minori24/VFDClock_LD8035/readme.md

# LD8035E VFD時計キット by Fablab Kannai

Fablab関内で開発した、VFD時計のキットです。Arduino Nanoをベースに、カシオミニで使われていたVFD管LD8035Eを6管点灯させるレトロな時計です。パーツ数を抑えたシンプルな構成ですが、ミニゲームやタイマーもついた高機能な時計です。

## 組み立て
[組み立てマニュアル](docs/assembly.md)
を参照して下さい。

## 設計情報
Cad: KiCad 5.0.2

プロジェクトデータはこのリポジトリにあります。

- [回路図 (PDF)](schematic/VFD_Clock_LD8035.pdf)

- [Arduino Code](Code)

## Contact

### 組み立てその他に関する問い合わせ

**Fablab Kannai**

http://fablab-kannai.org/

**Fablab Kannai @FB**

https://www.facebook.com/FabLabKannai/

### 設計情報について

@minori246

twitter.com/minori246
