minori24/VFDClock_LD8035/docs/kit.md

# Kit Preparation Checklist

## 部品(1台あたり)
- 基板 x1
- VFD(LD8035E) x6
- TBD62783APG x2
- Arduino Nano x1
- RTC Module (DS1307) x1
- ピンソケット(15ピン) x 2
- ピンソケット(5ピン) x 1
- ピンヘッダ(4ピン) x 2
- USB充電器 x 1
- USBケーブル x 1
- 抵抗(200Ω) x 6

## 下準備
### VFD
足カット

基板に差し込んで前後２箇所はんだ付け

### Arduino Nano
ピンヘッダはんだ付け

コード書き込み

### RTCモジュール
Diode外す

動作確認(動かなかったらR7に2012サイズ 680kOhmを実装してみる)
