minori24/VFDClock_LD8035/docs/images/50955239_2312329578779268_5980436892447932416_n.jpg

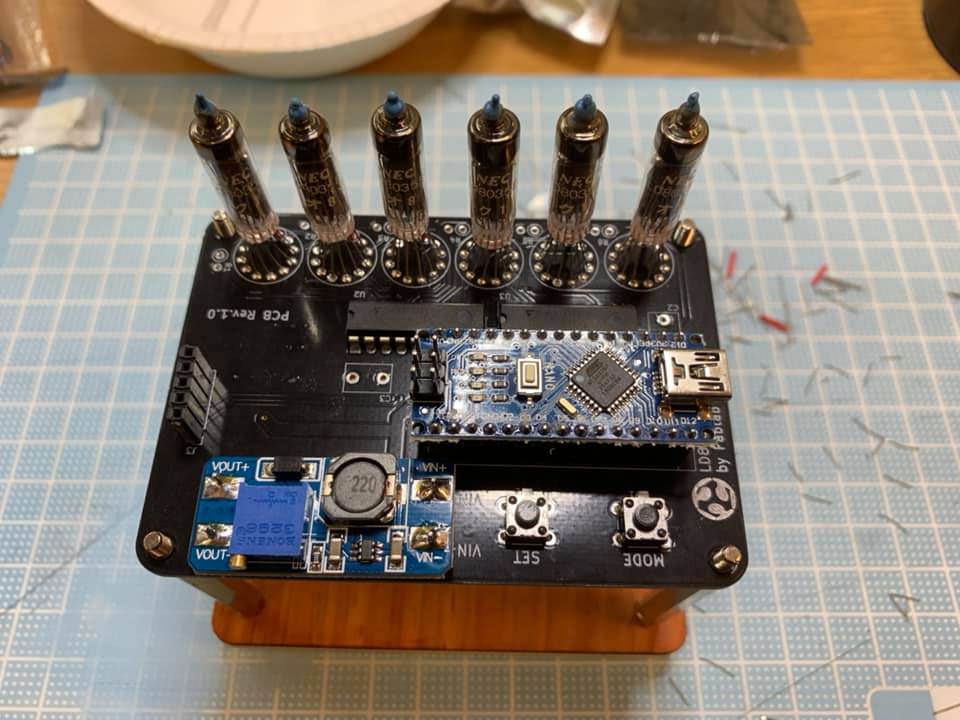
docs/images/50955239_2312329578779268_5980436892447932416_n.jpg
