minori24/VFDClock_LD8035/docs/images/51168129_2312329568779269_5029532683596726272_n.jpg

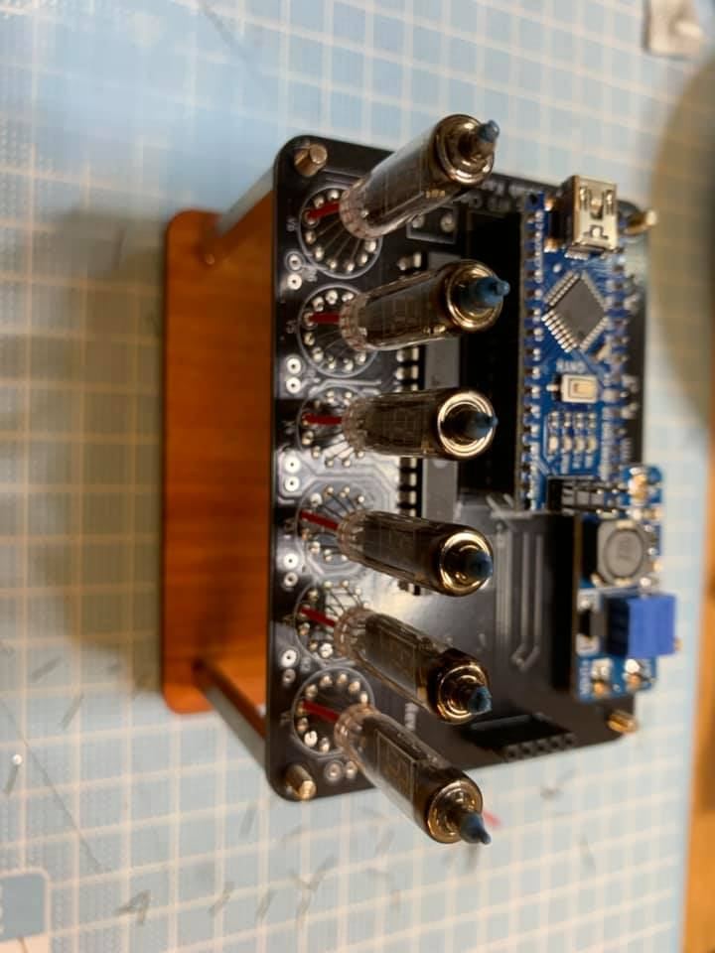
docs/images/51168129_2312329568779269_5029532683596726272_n.jpg
