minori24/VFDClock_LD8035/docs/images/51174301_2312329795445913_3582321986962980864_n.jpg

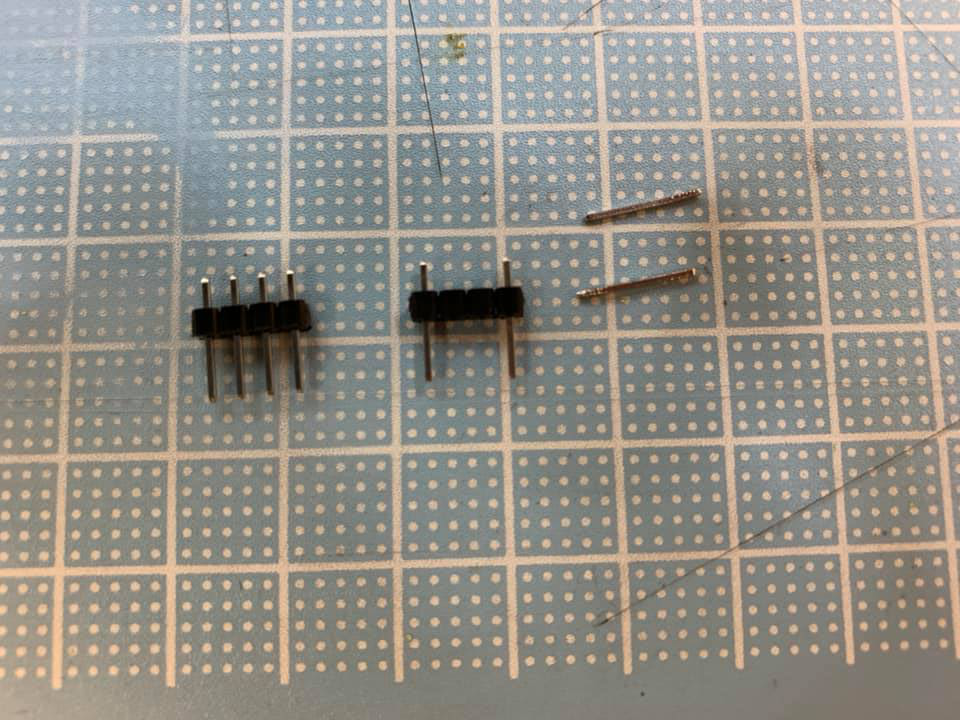
docs/images/51174301_2312329795445913_3582321986962980864_n.jpg
