minori24/VFDClock_LD8035/docs/images/51182363_2075365189222375_2331421364822474752_n.jpg

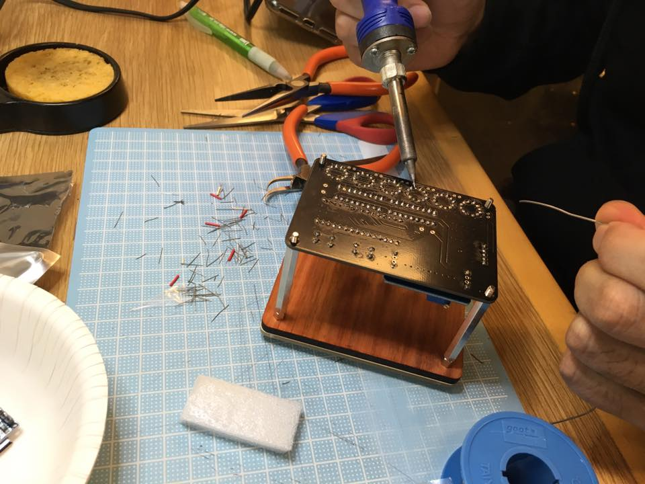
docs/images/51182363_2075365189222375_2331421364822474752_n.jpg
