minori24/VFDClock_LD8035/docs/images/51290638_2312329528779273_9056493839937699840_n.jpg

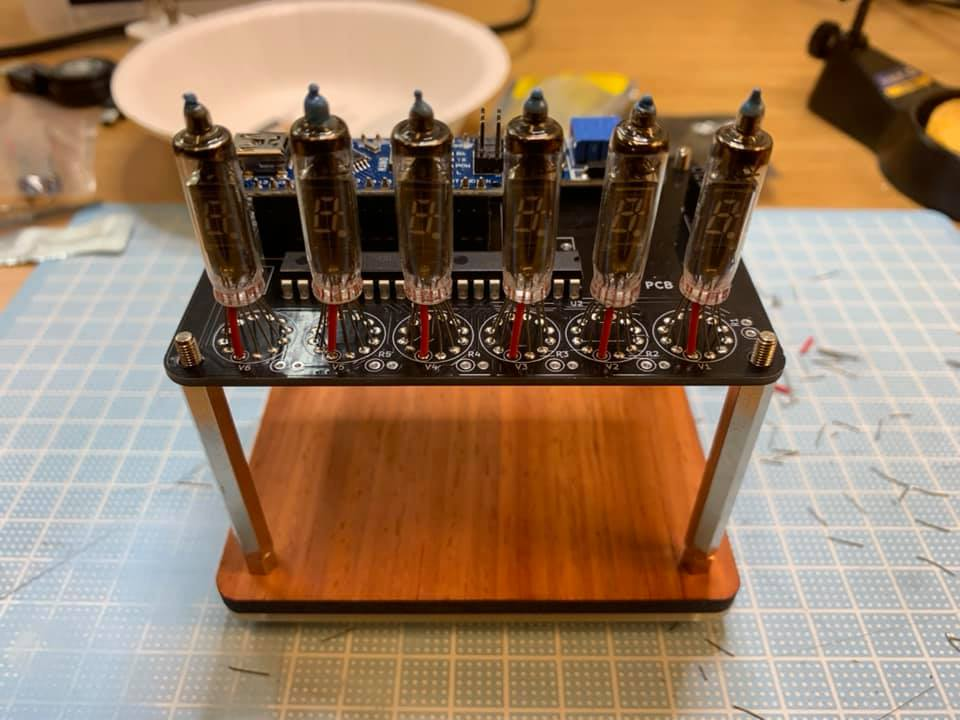
docs/images/51290638_2312329528779273_9056493839937699840_n.jpg
