minori24/VFDClock_LD8035/docs/images/51311653_2312329672112592_3221308682696392704_n.jpg

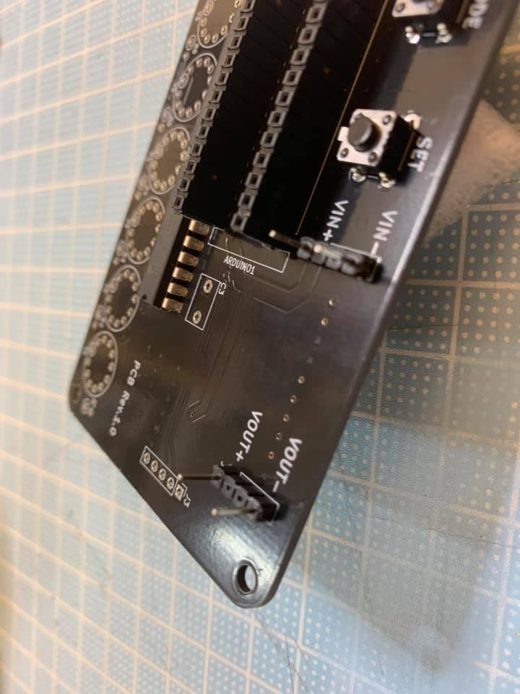
docs/images/51311653_2312329672112592_3221308682696392704_n.jpg
