minori24/VFDClock_LD8035/docs/images/51390263_2075368732555354_3693663860151025664_n.jpg

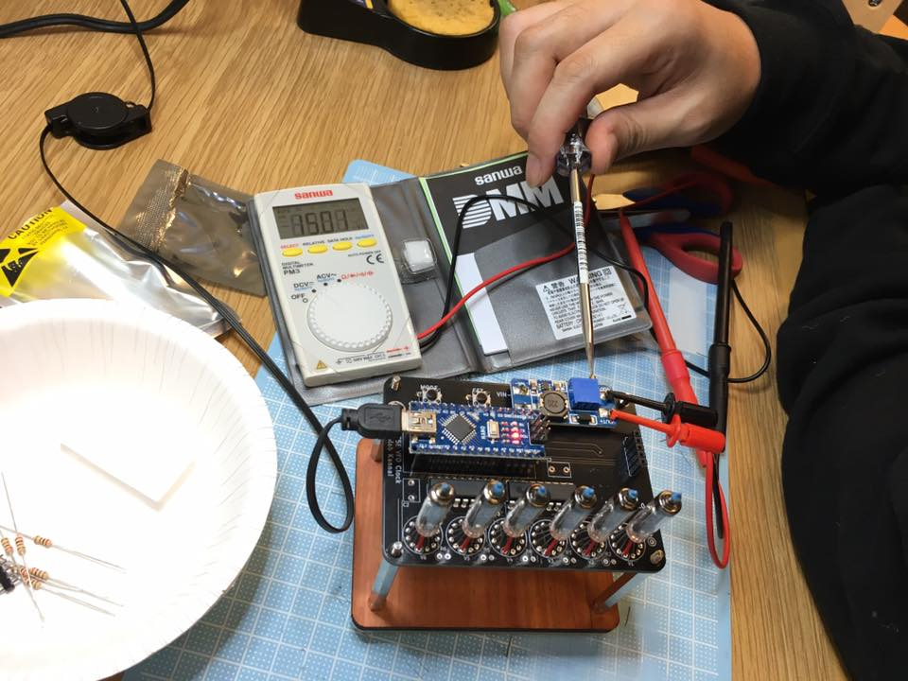
docs/images/51390263_2075368732555354_3693663860151025664_n.jpg
