minori24/VFDClock_LD8035/docs/images/51576585_2312329595445933_512756663497785344_n.jpg

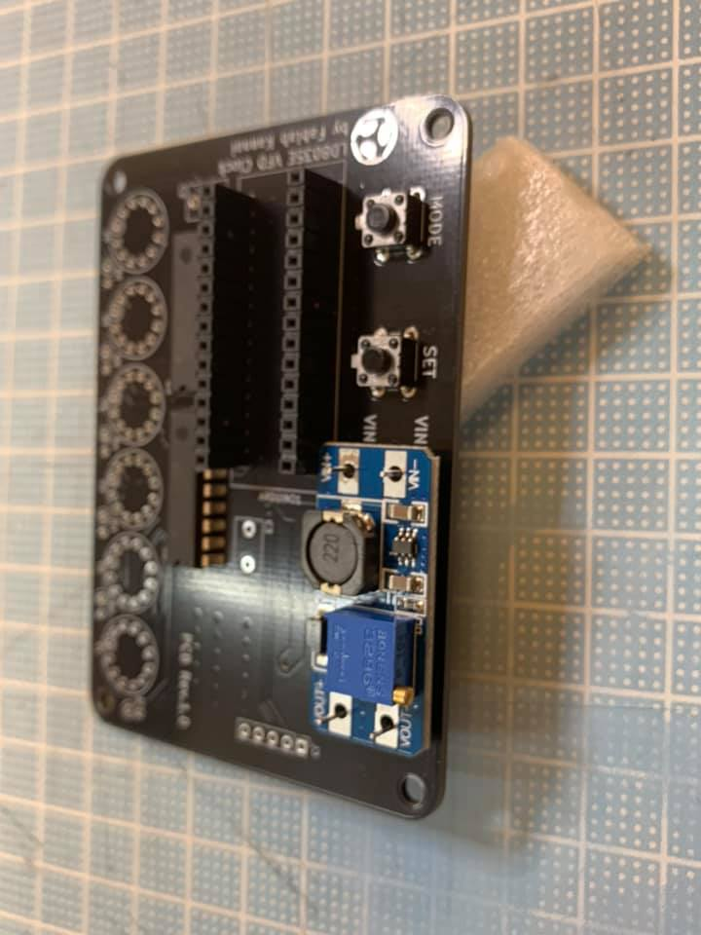
docs/images/51576585_2312329595445933_512756663497785344_n.jpg
