minori24/VFDClock_LD8035/docs/images/51658129_2312329715445921_3452039088956243968_n.jpg

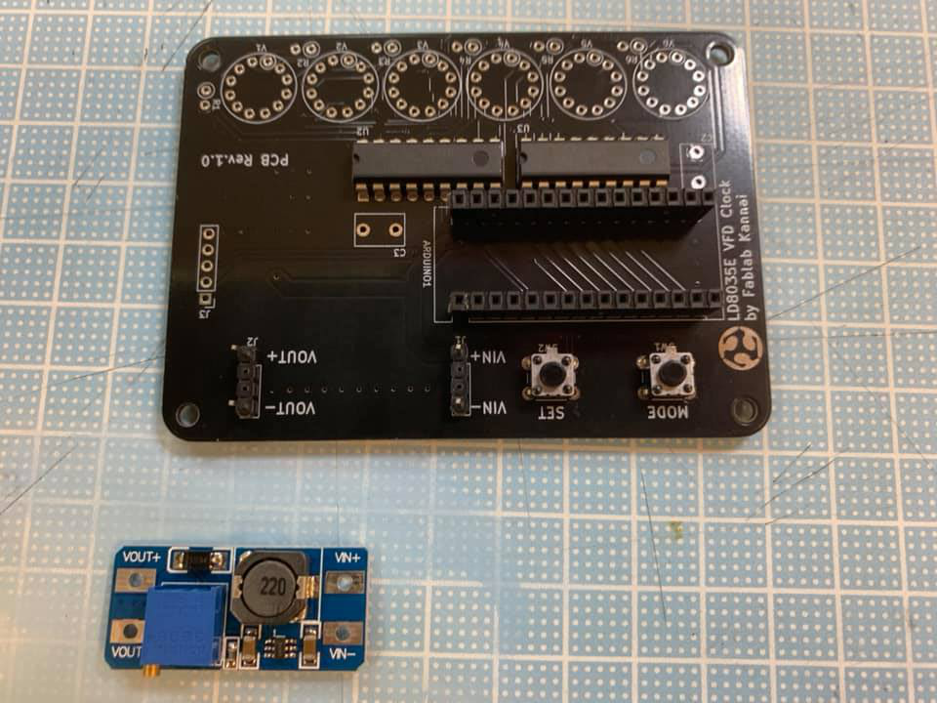
docs/images/51658129_2312329715445921_3452039088956243968_n.jpg
