minori24/VFDClock_LD8035/docs/images/51765231_2312329602112599_2057054421547745280_n.jpg

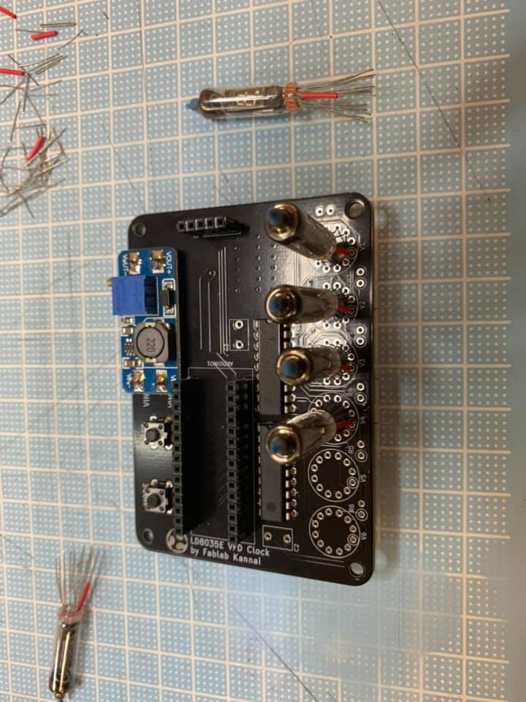
docs/images/51765231_2312329602112599_2057054421547745280_n.jpg
