minori24/VFDClock_LD8035/docs/images/pinhead_dcdc_2.png

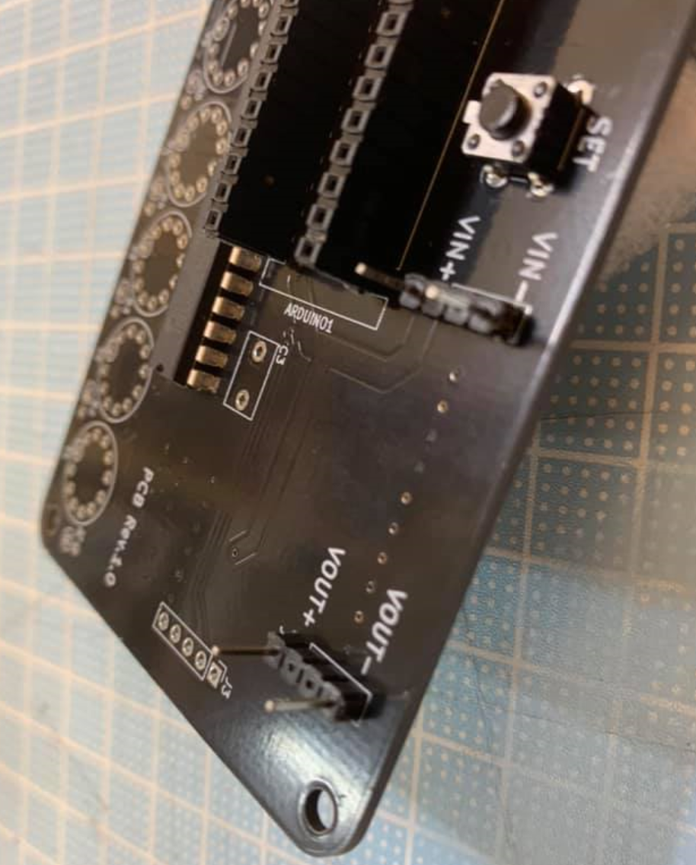
docs/images/pinhead_dcdc_2.png
