minori24/VFDClock_LD8035/base.dxf

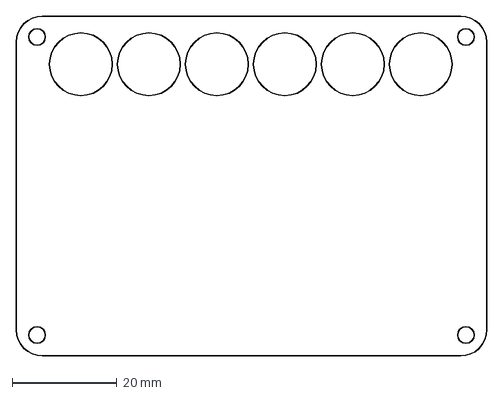
[picture p14: CAD file, 2018-04-09]
base.dxf
90.0 x 65.0 mm
