minori24/VFDClock_LD8035/Code/VfdClock/ChangeLog.md

# VfdClock.ino 変更履歴

## Ver. 06.02.00

* [SET]ボタンで、点滅効果ON/OFFができるようになりました。

## Ver. 06.01.02

* 操作方法を一部変更しました。

## Ver. 06.01.00

* ストップウォッチ機能を追加しました。

## Ver. 06.00.01

* ゲーム機能を内蔵しました。

* 操作方法を整理しました。

## Ver. 05.01.00

* 日時変更中に[SET]ボタンを連打すると、ダブルクリックと認識され、
バージョン表示に切り返してしまうバグを修正しました。

## Ver. 05.00.01

* ソースコードを全面的に見直して、オブジェクト指向にしました。
これにともなって、仕様もいくつか変更しています。
上記使用法をご参照下さい。

* ボタン長押し、ダブルクリック、トリプルクリック…を認識できるようになりました。

## Ver. 04.01.01

* 日付表示モードを追加しました。
[MODE]ボタン短押しで、日付を5秒間表示するようにしました。

* 桁が変化した直後にフラッシュ(1秒間点滅)するようにしました。
(秒の1の位以外)

* 「秒」の更新タイミング(1秒未満の誤差)を時刻設定タイミングに合うようにしました。
再起動した場合には、再度設定が必要。

* 時刻設定方法を変えました。秒の設定を可能にしました。
(「00秒」を待たずに時刻合わせをできます。)

## 以前の主な変更点

* 「時」の10の位が「0」のときは表示しないようにしました。
(市販の時計はほとんどこうなってると思います。)

* 時刻設定時に、変更する部分を点滅するようにしました。

* 起動直後5秒間、バージョン番号を点滅表示するようにしました。
(リセットすれば、バージョン番号を確認できます。)

* タイマー割り込みを使わずに、ほとんどloop()関数の中で処理するようにしました。
このため、FlexiTimer2は不要になりました。

* 時刻設定時は、[MODE]ボタンを**長押し**するようにしました。
時・分の切換は、短押しのままです。

* 秒の表示間隔がぶれるのを安定させました。
