minori24/VFDClock_LD8035/docs/Guide.pdf

## VFD Clock User Guide

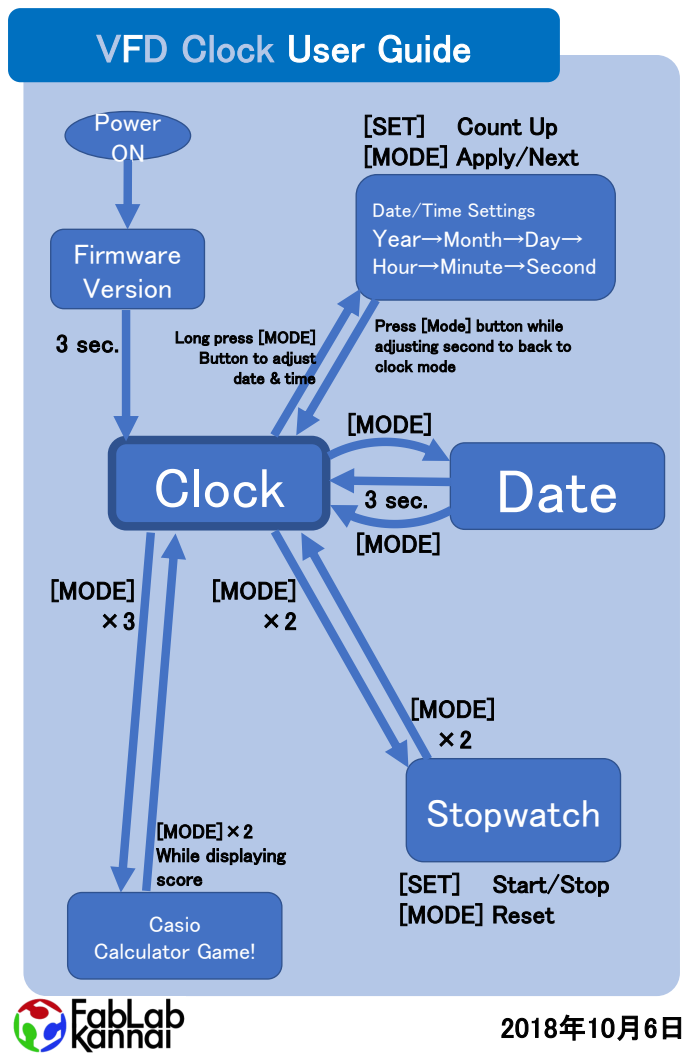
[picture p23: page 1]
Firmware Version; Power ON; Clock; Date; Stopwatch; Casio Calculator Game!; 3 sec.; [MODE]; [MODE] ×2; [MODE] ×3; [MODE]×2 While displaying score; [SET]; Start/Stop; [MODE] Reset; Count Up

[MODE] Apply/Next

Date/Time Settings
Year→Month→Day→
Hour→Minute→Second

Press [Mode] button while
adjusting second to back to
clock mode

Long press [MODE]
Button to adjust
date & time
