minori24/VFDClock_LD8035/schematic/VFD_Clock_LD8035.pdf

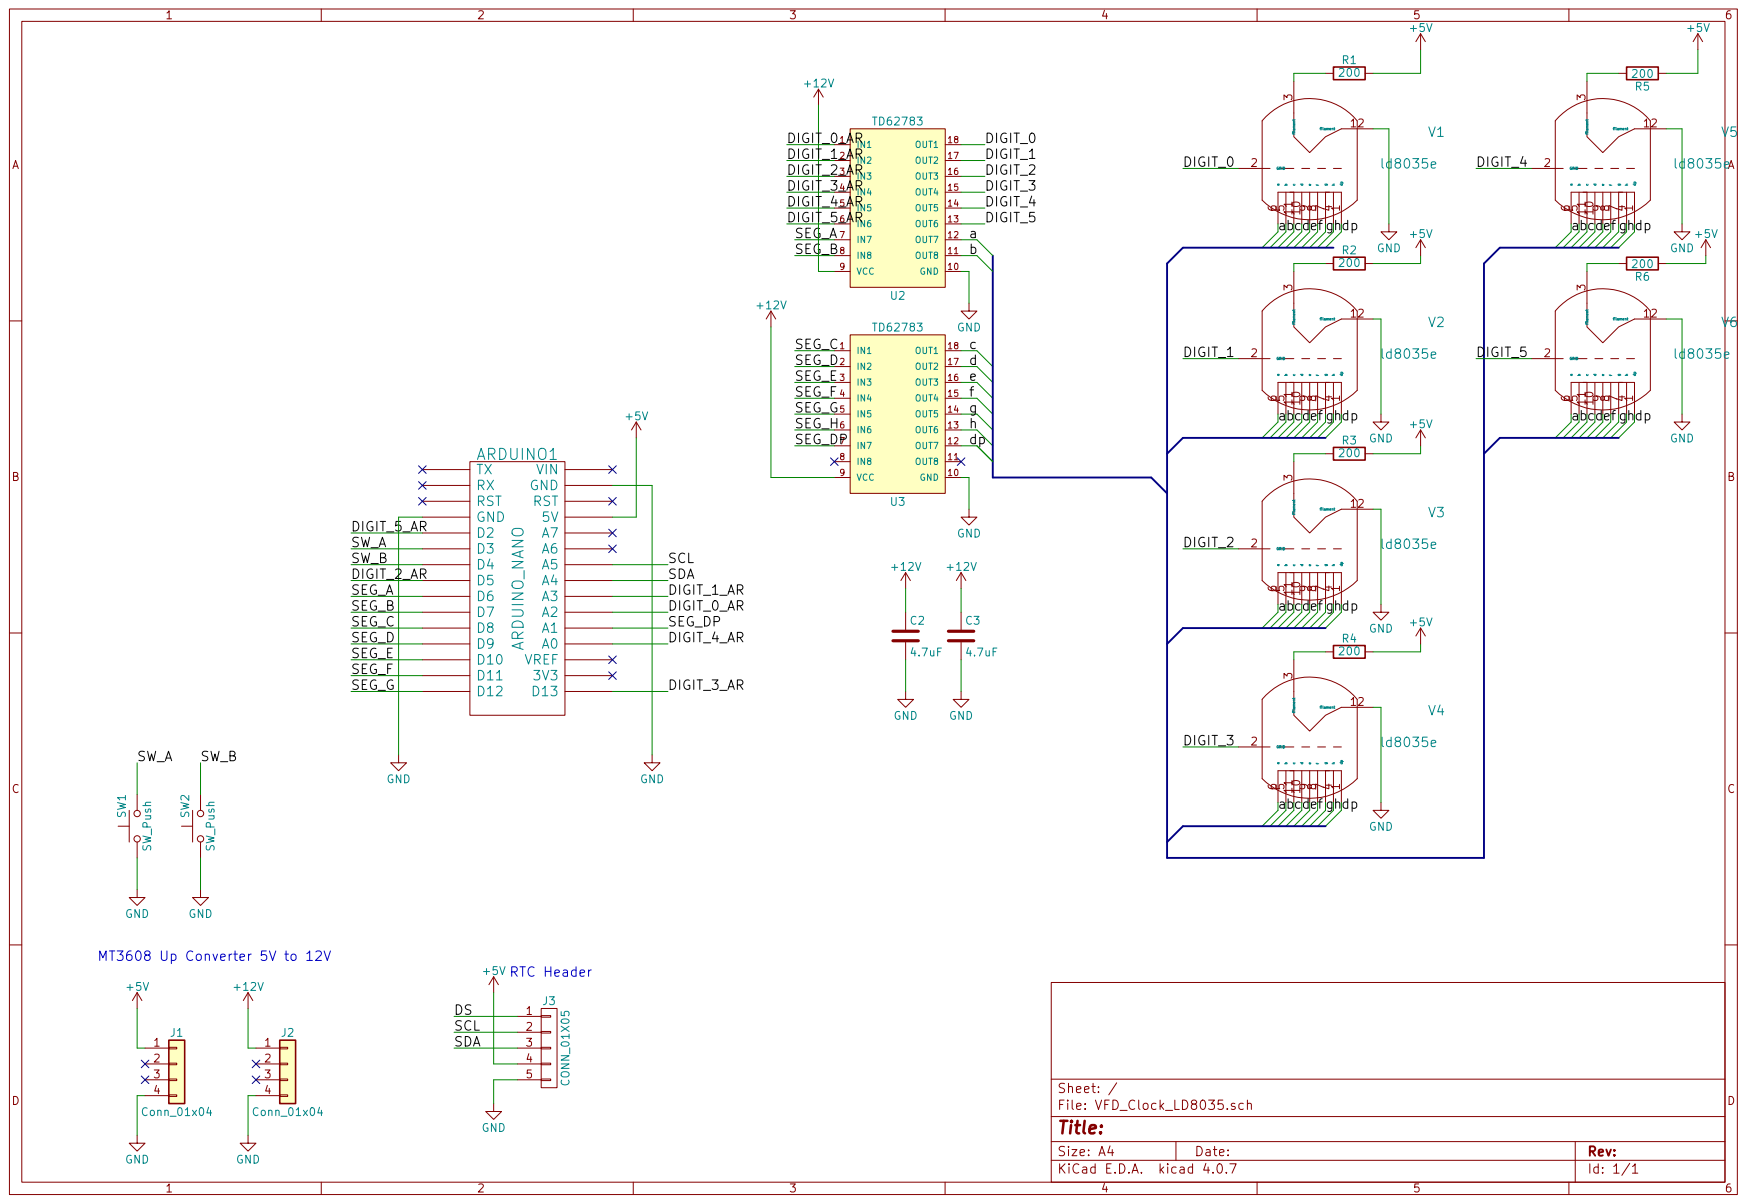
[picture p24: page 1]
