minori24/VFDClock_LD8035/Code/VFDTest/Button.h

// Button.h
// (c) 2018 FabLab Kannai
//
#ifndef BUTTON_H
#define BUTTON_H
#include <Arduino.h>

typedef unsigned long	id_t;
typedef uint8_t		button_event_t;
typedef uint8_t		count_t;

class Button {
 public:
  static const unsigned long	DEBOUNCE        	=   10;
  static const unsigned long	LONG_PRESS_MSEC 	= 1000;
  static const unsigned long	REPEAT_MSEC     	=  100;
  static const unsigned long	CLICK_MSEC		=  500;

  static const button_event_t	EVENT_NONE		= 0x00;
  static const button_event_t	EVENT_INTRRUPT		= 0x10;
  static const button_event_t	EVENT_PESSED		= 0x11;
  static const button_event_t	EVENT_RELEASED		= 0x12;
  static const button_event_t	EVENT_LONG_PRESSED 	= 0x02;
  static const button_event_t	EVENT_REPEAT		= 0x03;

  static const unsigned long	NUM_MAX = 10;
  static unsigned long		Num;
  static Button			*Obj[];

  Button();

  void    	init(byte pin, String name);

  boolean	get();

  void		enable();
  void		disable();
  boolean	isEnabled();

  String  	name();
  boolean 	value();
  count_t    	count();
  count_t	click_count();
  boolean	long_pressed();
  boolean	repeat();

  void    	print();
  void    	print(boolean interrupt);

 private:
  id_t		_id;
  String	_name;
  boolean	_is_enabled = false;
  byte		_pin;
  boolean	_value;      // HIGH/LOW
  boolean	_prev_value; // HIGH/LOW
  unsigned long	_first_press_start; // msec
  unsigned long	_press_start;       // msec
  count_t	_count;
  count_t	_click_count;
  boolean	_long_pressed;
  boolean	_repeat;

  void 		pciSetup(byte pin);
};

#endif
