minori24/VFDClock_LD8035/(commit log)

2018-04-22 Correct connection / Add dummy code
    [VFD_Clock_LD8035.kicad_pcb, VFD_Clock_LD8035.sch]
2018-04-22 Changed Resistor to 1/2W
    [VFD_Clock_LD8035.kicad_pcb, VFD_Clock_LD8035.sch]
2018-05-15 Changed button connection RTC implement
    [VFD_Clock_LD8035.kicad_pcb, VFD_Clock_LD8035.sch]
2018-05-30 Updated schematics / board
    [VFD_Clock_LD8035.kicad_pcb, VFD_Clock_LD8035.sch]
2018-08-26 Some fixes for Code
    [VFD_Clock_LD8035.kicad_pcb, VFD_Clock_LD8035.sch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]
2018-09-01 Pre-release for workshop
    [VFD_Clock_LD8035.kicad_pcb]
2018-09-02 Code optimization
    [VFD_Clock_LD8035.kicad_pcb]
2018-10-05 V1.0 Correct connection
    [VFD_Clock_LD8035-2018-09-12-18-54-02.sch, VFD_Clock_LD8035-2018-09-15-20-05-38.sch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]
2019-02-04 Add documentation
    [VFD_Clock_LD8035.kicad_pcb, VFD_Clock_LD8035.sch]
2019-09-18 Change RTC to DS3231 Raspberry Pi Module
    [VFD_Clock_LD8035.kicad_pcb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]
2019-10-22 Add English assembly manual
    [VFD_Clock_LD8035.kicad_pcb, VFD_Clock_LD8035.sch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]
2025-11-24 Update assembly_en.md
    Small description change
