minori24/VFDClock_LD8035/docs/images/IMG_0784.JPG

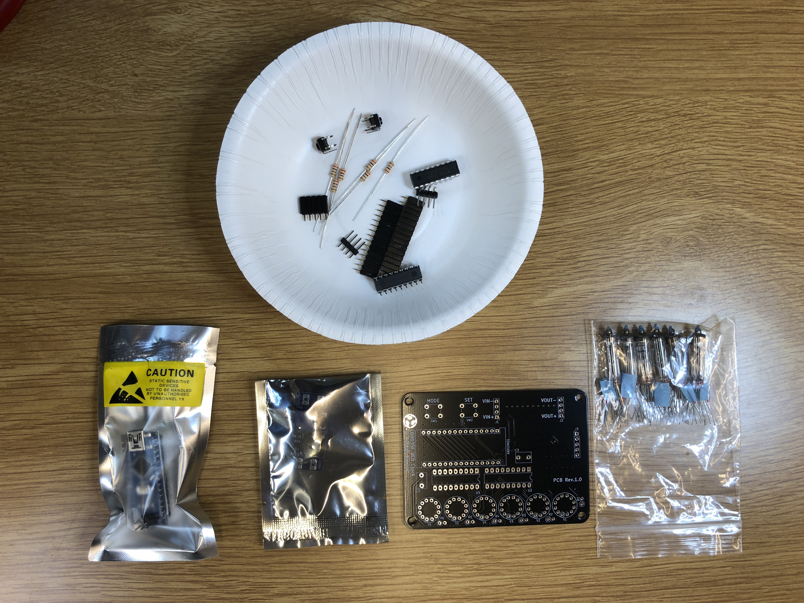
docs/images/IMG_0784.JPG
